hollyrock/AuraLinc-Community/docs/docs/repo-map.md

# リポジトリ案内

この公開コミュニティリポジトリで見られるファイルの場所です。

## オープンソースファイル

| フォルダ | 内容 |
| --- | --- |
| `firmware/main/` | EcoCONNECT制御用コード（microPython） |
| `firmware/pico2/` | 書き込み用ファームウェア(バイナリ＆ソース) |
| `hardware/main-board/` | メインボード設計ファイル（OSHWA） |
| `hardware/main-board/libs/` | KiCad シンボル・フットプリント |

## すすめ方

1. [技術情報](./getting-started) でEcoCONNECTを動かす
2. 設計を見たくなったら `hardware/main-board/` を KiCad で開く
