hollyrock/AuraLinc-Community/docs/en/community/index.md

# Community plaza

Share ideas, questions, and suggestions. This plaza is primarily in Japanese. English posts are welcome in the same thread.

You can also open [Discussions on GitHub](https://github.com/hollyrock/AuraLinc-Community/discussions).

<Giscus lang="en" />
