hollyrock/AuraLinc-Community/docs/en/docs/index.md

# Documentation

Technical documentation for EcoCONNECT: getting started, tutorials, where files live in the repository, and FAQ.

## Contents

| Page | What you’ll find |
| --- | --- |
| [What is EcoCONNECT?](./what-is-ecoconnect) | Project overview |
| [Repo map](./repo-map) | Public file locations |
| [Use with AuraLinc](./auralinc/tutorials/) | Manual for AuraLinc (commercial edition) |
| [Hack!](./hack/getting-started) | A step further into how to use the device |

Share ideas and questions in the [Community plaza](/en/community/).
Materials for education are in [Workshop materials](/en/steam/).
