hollyrock/AuraLinc-Community/docs/en/docs/repo-map.md

# Repo map

Where to find the open files in this public community repository.

## Open-source files

| Folder | Contents |
| --- | --- |
| `firmware/main/` | Control code for EcoCONNECT (MicroPython) |
| `firmware/pico2/` | Firmware to flash (binary and source) |
| `hardware/main-board/` | Main-board design files (OSHWA) |
| `hardware/main-board/libs/` | KiCad symbols and footprints |

## Suggested path

1. Get EcoCONNECT running with [Hack!](./hack/getting-started)
2. When you want to look at the design, open `hardware/main-board/` in KiCad
