hollyrock/AuraLinc-Community/docs/en/steam/classroom.md

# Workshop ideas

EcoCONNECT supports **Science, Technology, Engineering, Arts, and Mathematics** through short, tangible activities.

## Sample lesson hooks

| Subject | Prompt |
| --- | --- |
| Science | How does light in the room change during the day? |
| Technology | What does a sensor “tell” a computer? |
| Engineering | How would you protect a board used outdoors? |
| Arts | Turn sensor values into color, sound, or a paper data poster |
| Math | Graph 10 readings. What is the average? The range? |

## Facilitation tips

- Keep groups small (2–3 students)
- Aim for one clear question per session
- End with a share-out: each group says one discovery

## Share your lesson

Classroom adaptations are welcome in the [gallery](/en/community/) — photos of posters and student setups help the next teacher.
