hollyrock/AuraLinc-Community/docs/en/steam/examples.md

# Project examples

Need inspiration? Start with one of these small projects.

## Indoor light diary

Measure light in the same spot every hour for one day. Make a simple chart.

## Warm hands, cool air

Compare a reading near a window with a reading near the center of the room.

## Club demo booth

Prepare a 60-second demo: show a live reading and explain what the sensor detects.

## Remix ideas

- Add a paper enclosure (art + engineering)
- Translate labels into another language
- Design a better cable-management stand

When you finish a project, add it to the [gallery](/en/community/).
