hollyrock/AuraLinc-Community/docs/en/steam/recipes.md

# Recipes

Recipes are **tiny activities** you can finish in one short session.

## Recipe: Quiet baseline

1. Power on the board.
2. Don’t touch the sensor for one minute.
3. Write down the most common reading you see.
4. That number is your “quiet baseline.”

## Recipe: One change only

1. Note your baseline.
2. Change **one** thing (light, distance, airflow…).
3. Wait 20 seconds.
4. Note the new reading.
5. Talk about cause and effect.

## Recipe: Teach a friend

Explain EcoCONNECT to a partner in under two minutes using only everyday words — no jargon contest!
