hollyrock/AuraLinc-Community/docs/en/docs/hack/remote.md

# Send data wirelessly

How to send data collected by EcoCONNECT to a local PC.

## Data path from EcoCONNECT to the PC

## Configuration

1. Change the gateway settings.
2. Start the server service on the PC.
3. Check the data.
