hollyrock/AuraLinc-Community/docs/docs/hack/spec.md

# 移動しました

<script setup>
import { onMounted } from 'vue'
import { withBase } from 'vitepress'
onMounted(() => {
  window.location.replace(withBase('/docs/spec'))
})
</script>

このページは [仕様](/docs/spec) に移動しました。
