hollyrock/AuraLinc-Community/docs/index.md

---
layout: home

hero:
  name: AuraLinc
  text: コミュニティ
  tagline: ドキュメント・ワークショップ資料・みんなの広場。AuraLinc EcoCONNECT で広がるMakersの世界。
  actions:
    - theme: brand
      text: ドキュメント
      link: /docs/
    - theme: alt
      text: ワークショップ資料
      link: /steam/

features:
  - title: ドキュメント
    details: はじめ方、チュートリアル、技術情報はここに集約しています。
    link: /docs/
  - title: ワークショップ資料
    details: ワークショップや学校での利用に役立つテンプレート、ワークシート、短い活動例があります。
    link: /steam/
  - title: コミュニティ広場
    details: アイデア・質問・提案を共有。
    link: /community/
---
