hollyrock/AuraLinc-Community/docs/docs/index.md

# ドキュメント

EcoCONNECT の技術ドキュメントです。はじめ方・チュートリアル・リポジトリ内のファイル場所・FAQ をまとめています。

## 目次

| ページ | 内容 |
| --- | --- |
| [EcoCONNECT とは？](./what-is-ecoconnect) | プロジェクトの概要 |
| [リポジトリ案内](./repo-map) | 公開ファイルの場所 |
| [技術情報](./getting-started) | 一歩進んだ使い方をご紹介します |
| [AuraLincで使う](./auralinc/tutorials/) | AuraLinc（商用版）のマニュアル |

アイデアや質問の共有は [コミュニティ広場](/community/) へ。
教育向けの資料は [ワークショップ資料](/steam/) へ。
