hollyrock/AuraLinc-Community/docs/community/index.md

# コミュニティ広場

アイデア・質問・提案を分かち合う場所です。会話の基本は日本語です。英語でも同じスレッドに書けます。

[GitHub Discussions](https://github.com/hollyrock/AuraLinc-Community/discussions) で直接見ることもできます。

<Giscus lang="ja" />
