hollyrock/AuraLinc-Community/docs/docs/remote.md

# 無線でデータを送る

EcoCONNECTで取得したデータをローカルPCに送る方法を解説します。

## EcoCONNECTからPCまでのデータ経路

## コンフィギュレーション

1. ゲートウェイの設定を変更する。
2. PCでサーバーサービスを起動する。
3. データを確認する。
