hollyrock/AuraLinc-Community/docs/en/index.md

---
layout: home

hero:
  name: AuraLinc
  text: Community
  tagline: Docs, STEAM materials, and a shared plaza — AuraLinc EcoCONNECT by hollyRock for classrooms and clubs.
  actions:
    - theme: brand
      text: Docs
      link: /en/docs/
    - theme: alt
      text: Workshop
      link: /en/steam/

features:
  - title: Docs
    details: Getting started, tutorials, repo map, and FAQ — technical info in one place.
    link: /en/docs/
  - title: Workshop
    details: Classroom templates, worksheets, and short activities for educators.
    link: /en/steam/
  - title: Community
    details: Share ideas, questions, and suggestions via GitHub Discussions (giscus).
    link: /en/community/
---
