hollyrock/AuraLinc-Community/docs/steam/classroom.md

# ワークショップのアイデア

EcoCONNECT は、短い・手触りのある活動を通して **STEAM**（Science / Technology / Engineering / Arts / Mathematics）を支えます。

## ワークショップのとっかかり例

| 教科 | 問いかけ |
| --- | --- |
| Science | 教室の明るさは一日でどう変わる？ |
| Technology | センサーはコンピュータに何を「伝える」？ |
| Engineering | 屋外で使うとき、ボードをどう守る？ |
| Arts | センサーの値を色・音・紙のポスターにする |
| Math | 10 回測って平均と範囲を出す |

## 進め方のヒント

- グループは少人数（2〜3 人）
- 1 回の授業で問いをひとつに絞る
- 終わりに一言シェア：各グループが「発見」をひとつ発表

## ワークショップ案の共有

ワークショップでのでのアレンジは [ギャラリー](/community/) へどうぞ。ポスターやセットアップの写真が、次の助けになります。
