hollyrock/AuraLinc-Community/docs/steam/index.md

# ワークショップ資料

EcoCONNECT をワークショップ等で使うときの、テンプレート・ワークシートです。

## コンテンツ

| ページ | 内容 |
| --- | --- |
| [ワークショップ・アイデア](./classroom) | 内容別の問いかけと進め方 |
| [レシピ](./recipes) | 短時間で終わるアクティビティ |
| [事例](./examples) | 小さなプロジェクトのヒント |

技術的な手順やファイルの場所は [ドキュメント](/docs/) へ。
ワークショップの成果共有は [コミュニティ広場](/community/) へ。
