hollyrock/AuraLinc-Community/docs/steam/recipes.md

# レシピ

レシピは、短時間で終わる **小さなアクティビティ** です。
（順次公開予定です）
