hollyrock/AuraLinc-Community/docs/steam/examples.md

# プロジェクト事例

ヒントが欲しいときは、この小さなプロジェクトから。

## 室内の光日記

同じ場所の明るさを、1 時間ごとに 1 日測る。かんたんなグラフにする。

## あたたかい手、すずしい空気

窓際の計測と、部屋の中央の計測をくらべる。

## クラブのデモブース

60 秒デモを用意：ライブの数値を見せて、センサーが何を測っているか説明する。

## アレンジのアイデア

- 紙のケースを作る（Arts + Engineering）
- ラベルを別の言語にする
- ケーブル整理用のスタンドをデザインする

完成したら [ギャラリー](/community/) にどうぞ。
