hollyrock/AuraLinc-Community/docs/docs/hack/firmware.md

# 移動しました

<script setup>
import { onMounted } from 'vue'
import { withBase } from 'vitepress'
onMounted(() => {
  window.location.replace(withBase('/docs/firmware'))
})
</script>

このページは [ファームウェアと制御コードについて](/docs/firmware) に移動しました。
