hollyrock/AuraLinc-Community/docs/docs/hack/internal.md

# 移動しました

<script setup>
import { onMounted } from 'vue'
import { withBase } from 'vitepress'
onMounted(() => {
  window.location.replace(withBase('/docs/internal'))
})
</script>

このページは [EcoCONNECTの構造](/docs/internal) に移動しました。
