hollyrock/AuraLinc-Community/docs/docs/hack/recovery.md

# 移動しました

<script setup>
import { onMounted } from 'vue'
import { withBase } from 'vitepress'
onMounted(() => {
  window.location.replace(withBase('/docs/recovery'))
})
</script>

このページは [復旧](/docs/recovery) に移動しました。
