hollyrock/AuraLinc-Community/docs/docs/hack/remote.md

# 移動しました

<script setup>
import { onMounted } from 'vue'
import { withBase } from 'vitepress'
onMounted(() => {
  window.location.replace(withBase('/docs/remote'))
})
</script>

このページは [データを無線で送信する](/docs/remote) に移動しました。
