hollyrock/AuraLinc-Community/docs/docs/hack/ttn.md

# 移動しました

<script setup>
import { onMounted } from 'vue'
import { withBase } from 'vitepress'
onMounted(() => {
  window.location.replace(withBase('/docs/ttn'))
})
</script>

このページは [The Things Networkに繋げてみよう](/docs/ttn) に移動しました。
