hollyrock/AuraLinc-Community/docs/en/steam/index.md

# STEAM materials

Templates, worksheets, and short activities for educators using EcoCONNECT with STEAM in class.

## Contents

| Page | What you’ll find |
| --- | --- |
| [Classroom ideas](./classroom) | Subject prompts and facilitation tips |
| [Recipes](./recipes) | Quick session activities |
| [Examples](./examples) | Small project ideas |

Technical steps and file locations: [Docs](/en/docs/).  
Share outcomes and questions: [Community](/en/community/).
