hollyrock/AuraLinc-Community/docs/en/docs/hack/getting-started.md

# Let’s get started

Welcome!
This page introduces an overview of the technical information.

## Technical information

- [Structure](/en/docs/hack/internal)
- About the control code
- About the firmware
- About the LoRaWAN payload
- [Send data wirelessly](/en/docs/hack/remote)

## Other resources

- A [recipe](/en/steam/recipes) you can finish in about 10 minutes
- [Examples](/en/steam/examples) for ideas
- For teachers: [Workshop materials](/en/steam/)
