hollyrock/AuraLinc-Community/docs/docs/getting-started.md

# さぁ！始めよう！

ようこそ！
このページでは、ドキュメントの探索方法を紹介しています。

## EcoCONNECTの構造を理解する

- [EcoCONNECTの構造](/docs/internal)
- [ファームウェアと制御コードについて](/docs/firmware)

## EcoCONNECTのテクノロジを理解する

- [The Things Networkに繋げてみよう](/docs/ttn)
- [データを無線で送信する](/docs/remote)

## EcoCONNECTで何か作ってみる

- 10 分で終わる [レシピ](/steam/recipes)
- アイデア探しは [事例](/steam/examples)
- 先生向け：[ワークショップ資料](/steam/)
