hollyrock/AuraLinc-Community/docs/docs/hack/getting-started.md

# 移動しました

<script setup>
import { onMounted } from 'vue'
import { withBase } from 'vitepress'
onMounted(() => {
  window.location.replace(withBase('/docs/getting-started'))
})
</script>

このページは [ドキュメント](/docs/getting-started) に移動しました。
