hollyrock/AuraLinc-Community/docs/docs/tutorials/first-reading.md

# 移動しました

<script setup>
import { onMounted } from 'vue'
import { withBase } from 'vitepress'
onMounted(() => {
  window.location.replace(withBase('/docs/auralinc/tutorials/first-reading'))
})
</script>

はじめての計測は [はじめてのEcoCONNECT](/docs/auralinc/tutorials/first-reading) に移動しました。
