hollyrock/AuraLinc-Community/docs/docs/tutorials/index.md

# 移動しました

<script setup>
import { onMounted } from 'vue'
import { withBase } from 'vitepress'
onMounted(() => {
  window.location.replace(withBase('/docs/auralinc/tutorials/'))
})
</script>

チュートリアルは [AuraLincで使う](/docs/auralinc/tutorials/) に移動しました。
