hollyrock/AuraLinc-Community/docs/en/docs/getting-started.md

# Moved

<script setup>
import { onMounted } from 'vue'
import { withBase } from 'vitepress'
onMounted(() => {
  window.location.replace(withBase('/en/docs/hack/getting-started'))
})
</script>

Getting started moved to [Let’s get started](/en/docs/hack/getting-started).
