hollyrock/AuraLinc-Community/docs/docs/auralinc/tutorials/index.md

# チュートリアル

短いガイドつきのアクティビティです。上から順に進めると安心です。

## 初心者向けの道すじ

1. [はじめ方](/docs/getting-started) — 電源オンと書き込み
2. [はじめてのセンサー計測](/docs/auralinc/tutorials/first-reading) — 本物の数値を観察
3. [レシピ](/steam/recipes) をひとつ選ぶ — 小さな実験

## うまく進めるコツ

- 一度に一歩だけ読む
- うまくいかないときは、ひとつ前の手順に戻る
- 見たことをノートに書く — よい観察の第一歩です
