hollyrock/AuraLinc-Community/docs/en/docs/tutorials/first-reading.md

# Moved

<script setup>
import { onMounted } from 'vue'
import { withBase } from 'vitepress'
onMounted(() => {
  window.location.replace(withBase('/en/docs/auralinc/tutorials/first-reading'))
})
</script>

The first reading moved to [Your first EcoCONNECT](/en/docs/auralinc/tutorials/first-reading).
