hollyrock/AuraLinc-Community/docs/en/docs/tutorials/index.md

# Moved

<script setup>
import { onMounted } from 'vue'
import { withBase } from 'vitepress'
onMounted(() => {
  window.location.replace(withBase('/en/docs/auralinc/tutorials/'))
})
</script>

Tutorials moved to [Use with AuraLinc](/en/docs/auralinc/tutorials/).
