hollyrock/AuraLinc-Community/site/docs/tutorials/first-reading.html

Skip to content

 AuraLinc Community

日本語

English

(https://github.com/hollyrock/AuraLinc-Community)

日本語

English

外観

(https://github.com/hollyrock/AuraLinc-Community)

メニュー

ページ上部へ

# 移動しました

はじめての計測は はじめてのEcoCONNECT に移動しました。

好奇心あふれる社会づくりに貢献する

AuraLinc community / hollyRock
