hollyrock/AuraLinc-Community/site/en/docs/getting-started.html

Skip to content

 AuraLinc

English

日本語

(https://github.com/hollyrock/AuraLinc-Community)

English

日本語

Appearance

(https://github.com/hollyrock/AuraLinc-Community)

Menu

Return to top

# Moved

Getting started moved to Let’s get started.

Deliver the curiosity of STEAM to the world

AuraLinc community / hollyRock
