hollyrock/AuraLinc-Community/site/docs/auralinc/tutorials/index.html

Skip to content

 AuraLinc Community

日本語

English

(https://github.com/hollyrock/AuraLinc-Community)

日本語

English

外観

(https://github.com/hollyrock/AuraLinc-Community)

メニュー

ページ上部へ

# チュートリアル

短いガイドつきのアクティビティです。上から順に進めると安心です。

## 初心者向けの道すじ

1. はじめ方 — 電源オンと書き込み
2. はじめてのセンサー計測 — 本物の数値を観察
3. レシピ をひとつ選ぶ — 小さな実験

## うまく進めるコツ

- 一度に一歩だけ読む
- うまくいかないときは、ひとつ前の手順に戻る
- 見たことをノートに書く — よい観察の第一歩です

好奇心あふれる社会づくりに貢献する

AuraLinc community / hollyRock
