hollyrock/AuraLinc-Community/site/en/docs/tutorials/first-reading.html

Skip to content

 AuraLinc

English

日本語

(https://github.com/hollyrock/AuraLinc-Community)

English

日本語

Appearance

(https://github.com/hollyrock/AuraLinc-Community)

Menu

Return to top

# Moved

The first reading moved to Your first EcoCONNECT.

Deliver the curiosity of STEAM to the world

AuraLinc community / hollyRock
