hollyrock/AuraLinc-Community/site/en/docs/auralinc/tutorials/index.html

Skip to content

 AuraLinc

English

日本語

(https://github.com/hollyrock/AuraLinc-Community)

English

日本語

Appearance

(https://github.com/hollyrock/AuraLinc-Community)

Menu

Return to top

# Tutorials

Short guided activities. Start at the top and move down when you feel ready.

## Path for beginners

1. Getting started — power on and flash
2. Your first EcoCONNECT — watch a real measurement
3. Pick a recipe — try a small experiment

## Tips

- Read one step at a time
- If a step fails, go back one step
- Write down what you see — good observation starts with notes

Deliver the curiosity of STEAM to the world

AuraLinc community / hollyRock
