hollyrock/AuraLinc-Community/docs/docs/auralinc/faq.md

# FAQ

よくある質問です。ここにない内容は [コミュニティ広場](/community/) で聞いてください。

## ボード・書き込み

### 書き込み用のドライブが見つかりません

BOOTSEL を押しながら USB をさし直してください。Raspberry Pi Pico では、多くの場合 `RPI-RP2` という名前のドライブが表示されます。

### どのファイルをコピーすればよいですか？

`firmware/pico2/release/ecoconnect-pico2.uf2` を使います。手順は [はじめ方](../getting-started) と `firmware/pico2/README.md` を参照してください。

### 書き込み後に何も起きません

ケーブルを抜け差しし、電源ランプの有無を確認してください。それでもだめなら [コミュニティ広場](/community/) に状況（OS・ケーブル・表示されたドライブ名）を書いてください。

## ドキュメント・教室

### 授業用のワークシートはどこ？

[ワークショップ資料](/steam/) にテンプレートと短い活動例があります。

### 回路や設計ファイルはどこ？

[リポジトリ案内](../repo-map) を見てください。公開しているのはボード設計と書き込み用イメージです。

## コミュニティ

### 質問やアイデアはどこに投稿する？

[コミュニティ広場](/community/)（GitHub Discussions）を使います。
