hollyrock/AuraLinc-Community/hardware/main-board/ecoconnect-main-board.kicad_pcb

## KiCad design hardware/main-board/ecoconnect-main-board.kicad_pcb (2026-10-13)

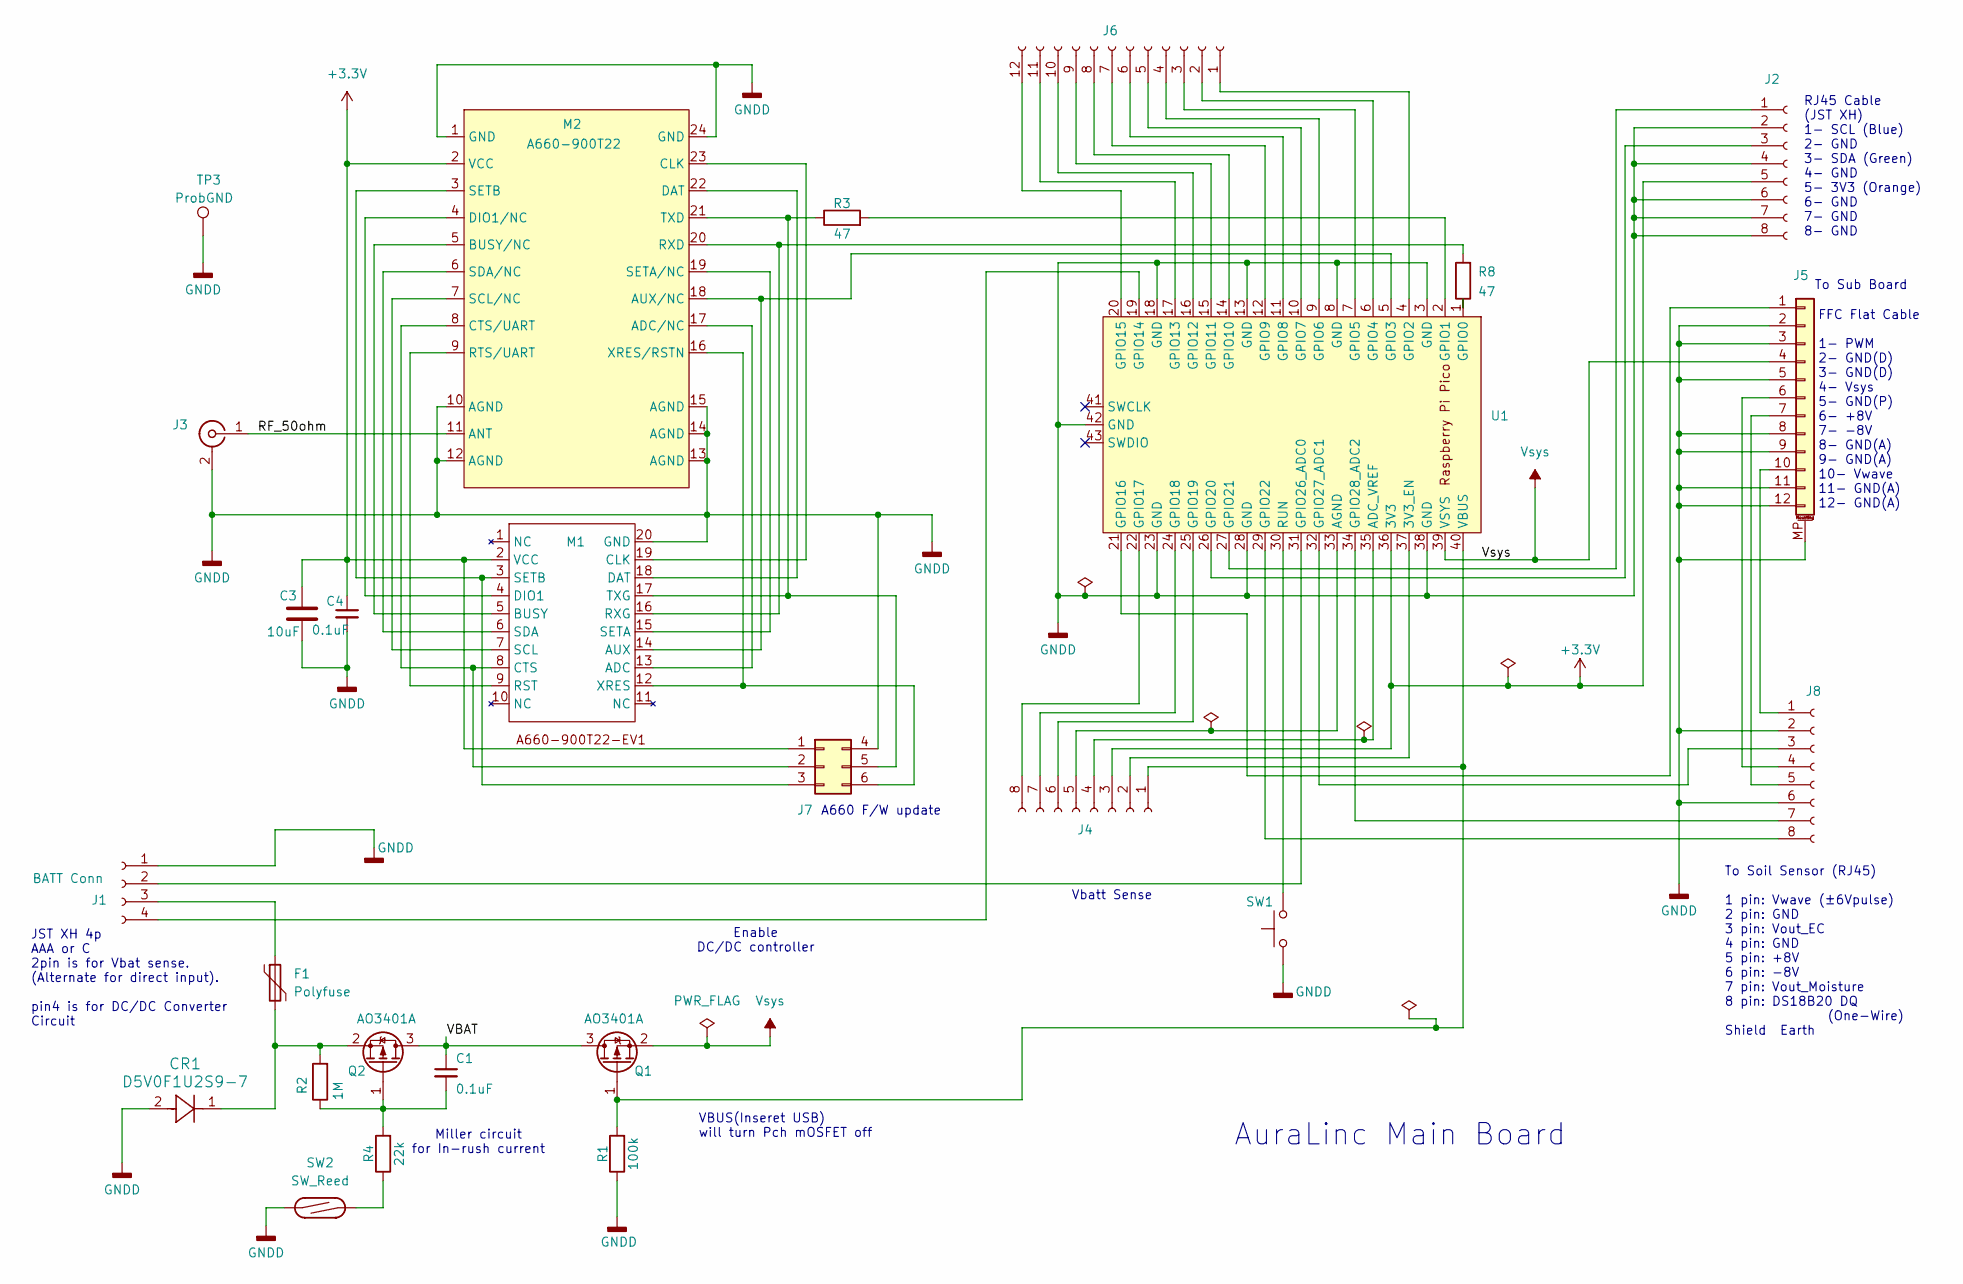
[picture p4: schematic ecoconnect-main-board.kicad_sch, AuraLinc Project]

Parts:
C1, C4: 0.1uF; C_0603_1608Metric_Pad1.08x0.95mm_HandSolder
C3: 10uF; C_0805_2012Metric_Pad1.18x1.45mm_HandSolder
CR1: D5V0F1U2S9-7; D5V0F1U2S9
F1: Polyfuse; FUS_MINISMDC075F_TYCO_TYC
J1: BATT Conn; JST_XH_B4B-XH-A_1x04_P2.50mm_Vertical
J2, J8: Conn_01x08_Socket; JST_XH_B8B-XH-AM_1x08_P2.50mm_Vertical
J3: Conn_Coaxial; SMA_Samtec_SMA-J-P-H-ST-EM1_EdgeMount
J4: Conn_01x08_Socket; PinHeader_1x08_P2.54mm_Vertical
J5: Conn_01x12_MountingPin; TE_1-84952-2_1x12-1MP_P1.0mm_Horizontal
J6: Conn_01x12_Socket; PinHeader_1x12_P2.54mm_Vertical
J7: Conn_02x03_Top_Bottom; PinSocket_2x03_P2.54mm_Vertical
M1: A660-900T22-EV1
M2: A660-900T22
Q1, Q2: AO3401A; SOT-23
R1: 100k; R_0805_2012Metric_Pad1.20x1.40mm_HandSolder
R2: 1M; R_0805_2012Metric_Pad1.20x1.40mm_HandSolder
R3, R8: 47; R_0805_2012Metric_Pad1.20x1.40mm_HandSolder
R4: 22k; R_0805_2012Metric_Pad1.20x1.40mm_HandSolder
SW1: SW_Omron_B3FS; SW_SPST_Omron_B3FS-100xP
SW2: SW_Reed; JST_XH_B2B-XH-AM_1x02_P2.50mm_Vertical
TP3: ProbGND; TestPoint_Keystone_5015_Micro_Mini
U1: RPi_Pico_SMD_TH

Connections:
+3.3V: C3.1, C4.1, J2.5, J4.3, J7.1, M1.2 (VCC), M2.2 (VCC), U1.36 (3V3)
/RF_50ohm: J3.1 (In), M2.11 (ANT)
/VBAT: C1.1, Q1.3 (D), Q2.3 (D)
GNDD: C3.2, C4.2, CR1.2, J1.1, J2.2, J2.4, J2.6, J2.7, J2.8, J3.2 (Ext), J5.2, J5.3, J5.5, J5.8, J5.9, J5.11, J5.12, J5.MP (MountPin), J7.4, J8.2, J8.6, M1.20 (GND), M2.1 (GND), M2.10 (AGND), M2.12 (AGND), M2.13 (AGND), M2.14 (AGND), M2.15 (AGND), M2.24 (GND), R1.1, SW1.1, SW2.1, TP3.1, U1.3 (GND), U1.8 (GND), U1.13 (GND), U1.18 (GND), U1.23 (GND), U1.28 (GND), U1.38 (GND), U1.42 (GND)
unnamed: J1.2, U1.31 (GPIO26_ADC0)
unnamed: F1.1, J1.3
unnamed: J1.4, U1.19 (GPIO14)
unnamed: J2.1, U1.27 (GPIO21)
unnamed: J2.3, U1.26 (GPIO20)
unnamed: J4.1, Q1.1 (G), R1.2, U1.40 (VBUS)
unnamed: J4.2, U1.37 (3V3_EN)
unnamed: J4.4, U1.35 (ADC_VREF)
unnamed: J4.5, U1.33 (AGND)
unnamed: J4.6, U1.25 (GPIO19)
unnamed: J4.7, U1.24 (GPIO18)
unnamed: J4.8, U1.22 (GPIO17)
unnamed: J5.1, U1.21 (GPIO16)
unnamed: J5.6, J8.4
unnamed: J5.7, J8.5
unnamed: J5.10, J8.1
unnamed: J6.1, U1.4 (GPIO2)
unnamed: J6.2, U1.6 (GPIO4)
unnamed: J6.3, U1.7 (GPIO5)
unnamed: J6.4, U1.9 (GPIO6)
unnamed: J6.5, U1.10 (GPIO7)
unnamed: J6.6, U1.11 (GPIO8)
unnamed: J6.7, U1.12 (GPIO9)
unnamed: J6.8, U1.14 (GPIO10)
unnamed: J6.9, U1.15 (GPIO11)
unnamed: J6.10, U1.16 (GPIO12)
unnamed: J6.11, U1.17 (GPIO13)
unnamed: J6.12, U1.20 (GPIO15)
unnamed: J7.2, M1.8 (CTS), M2.8 (CTS/UART)
unnamed: J7.3, M1.3 (SETB), M2.3 (SETB)
unnamed: J7.5, M1.17 (TXG), M2.21 (TXD), R3.1
unnamed: J7.6, M1.12 (XRES), M2.16 (XRES/RSTN)
unnamed: J8.3, U1.32 (GPIO27_ADC1)
unnamed: J8.7, U1.34 (GPIO28_ADC2)
unnamed: J8.8, U1.29 (GPIO22)
unnamed: M1.13 (ADC), M2.17 (ADC/NC)
unnamed: M1.14 (AUX), M2.18 (AUX/NC), U1.5 (GPIO3)
unnamed: M1.5 (BUSY), M2.5 (BUSY/NC)
unnamed: M1.19 (CLK), M2.23 (CLK)
unnamed: M1.18 (DAT), M2.22 (DAT)
unnamed: M1.4 (DIO1), M2.4 (DIO1/NC)
unnamed: M1.9 (RST), M2.9 (RTS/UART)
unnamed: M1.16 (RXG), M2.20 (RXD), R8.2
unnamed: M1.7 (SCL), M2.7 (SCL/NC)
unnamed: M1.6 (SDA), M2.6 (SDA/NC)
unnamed: M1.15 (SETA), M2.19 (SETA/NC)
unnamed: C1.2, Q2.1 (G), R2.1, R4.2
unnamed: CR1.1, F1.2, Q2.2 (S), R2.2
unnamed: R4.1, SW2.2
unnamed: R8.1, U1.1 (GPIO0)
unnamed: R3.2, U1.2 (GPIO1)
unnamed: SW1.2, U1.30 (RUN)
Vsys: J5.4, Q1.2 (S), U1.39 (VSYS)

Notes on the sheet:
To Soil Sensor (RJ45) 1 pin: Vwave (±6Vpulse) 2 pin: GND 3 pin: Vout_EC 4 pin: GND 5 pin: +8V 6 pin: -8V 7 pin: Vout_Moisture 8 pin: DS18B20 DQ (One-Wire) Shield Earth
FFC Flat Cable 1- PWM 2- GND(D) 3- GND(D) 4- Vsys 5- GND(P) 6- +8V 7- -8V 8- GND(A) 9- GND(A) 10- Vwave 11- GND(A) 12- GND(A)
To Sub Board
A660 F/W update
AuraLinc Main Board
Miller circuit for In-rush current
VBUS(Inseret USB) will turn Pch mOSFET off
Enable DC/DC controller
Vbatt Sense
RJ45 Cable (JST XH) 1- SCL (Blue) 2- GND 3- SDA (Green) 4- GND 5- 3V3 (Orange) 6- GND 7- GND 8- GND
JST XH 4p AAA or C 2pin is for Vbat sense. (Alternate for direct input). pin4 is for DC/DC Converter Circuit

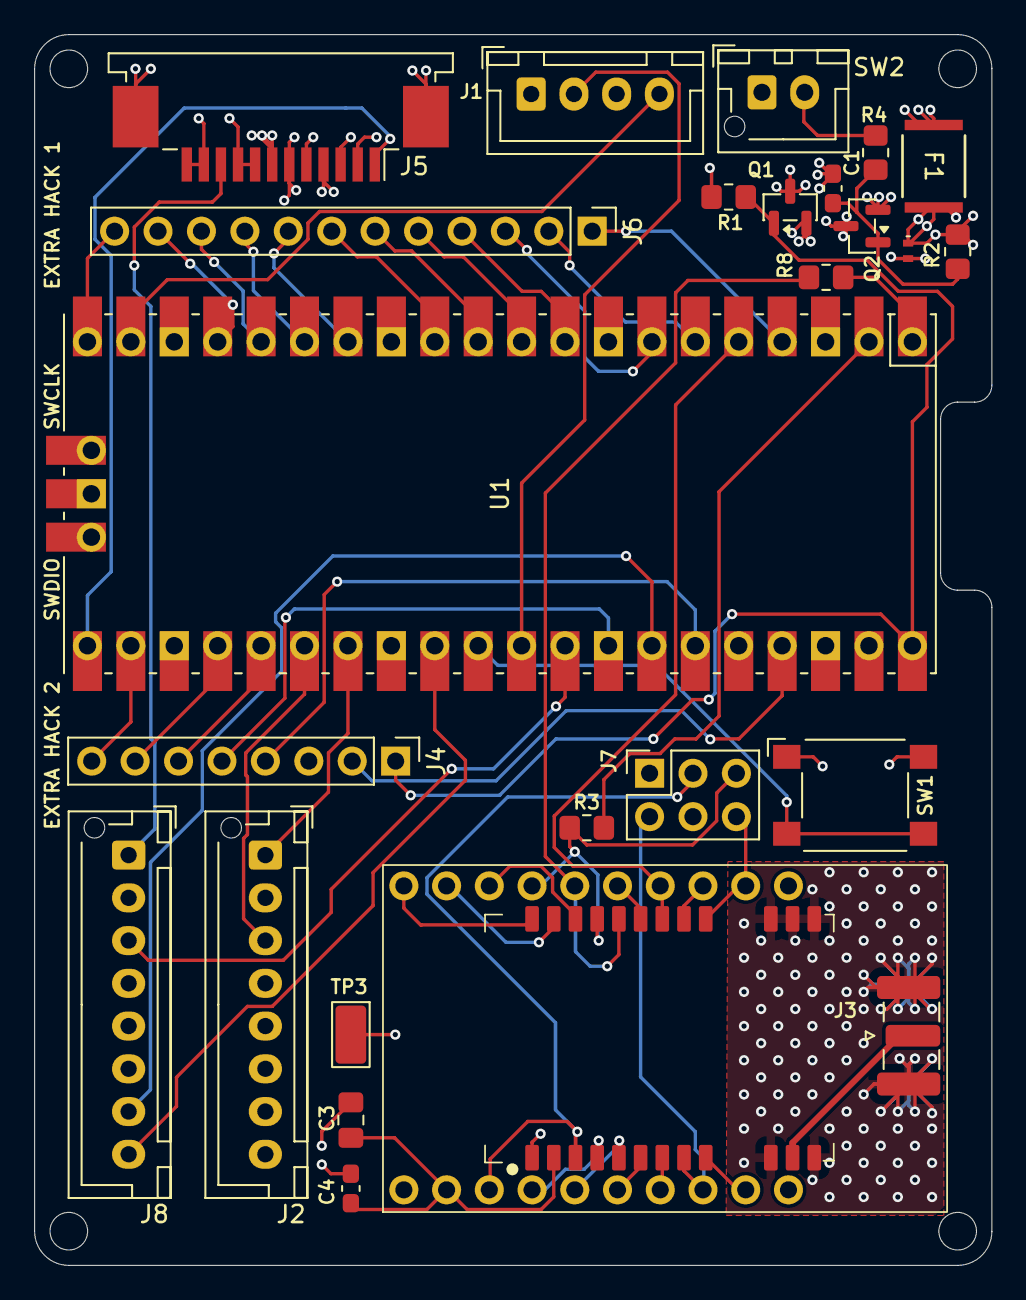
[picture p5: board ecoconnect-main-board.kicad_pcb from above]

Board: 4 copper layers, 56.0 x 72.0 mm, 26 parts (0 on the bottom side), 57 nets.
