hollyrock/AuraLinc-Community/hardware/steam-board/ecoconnect-steam-board.kicad_pcb

## KiCad design hardware/steam-board/ecoconnect-steam-board.kicad_pcb (2026-10-13)

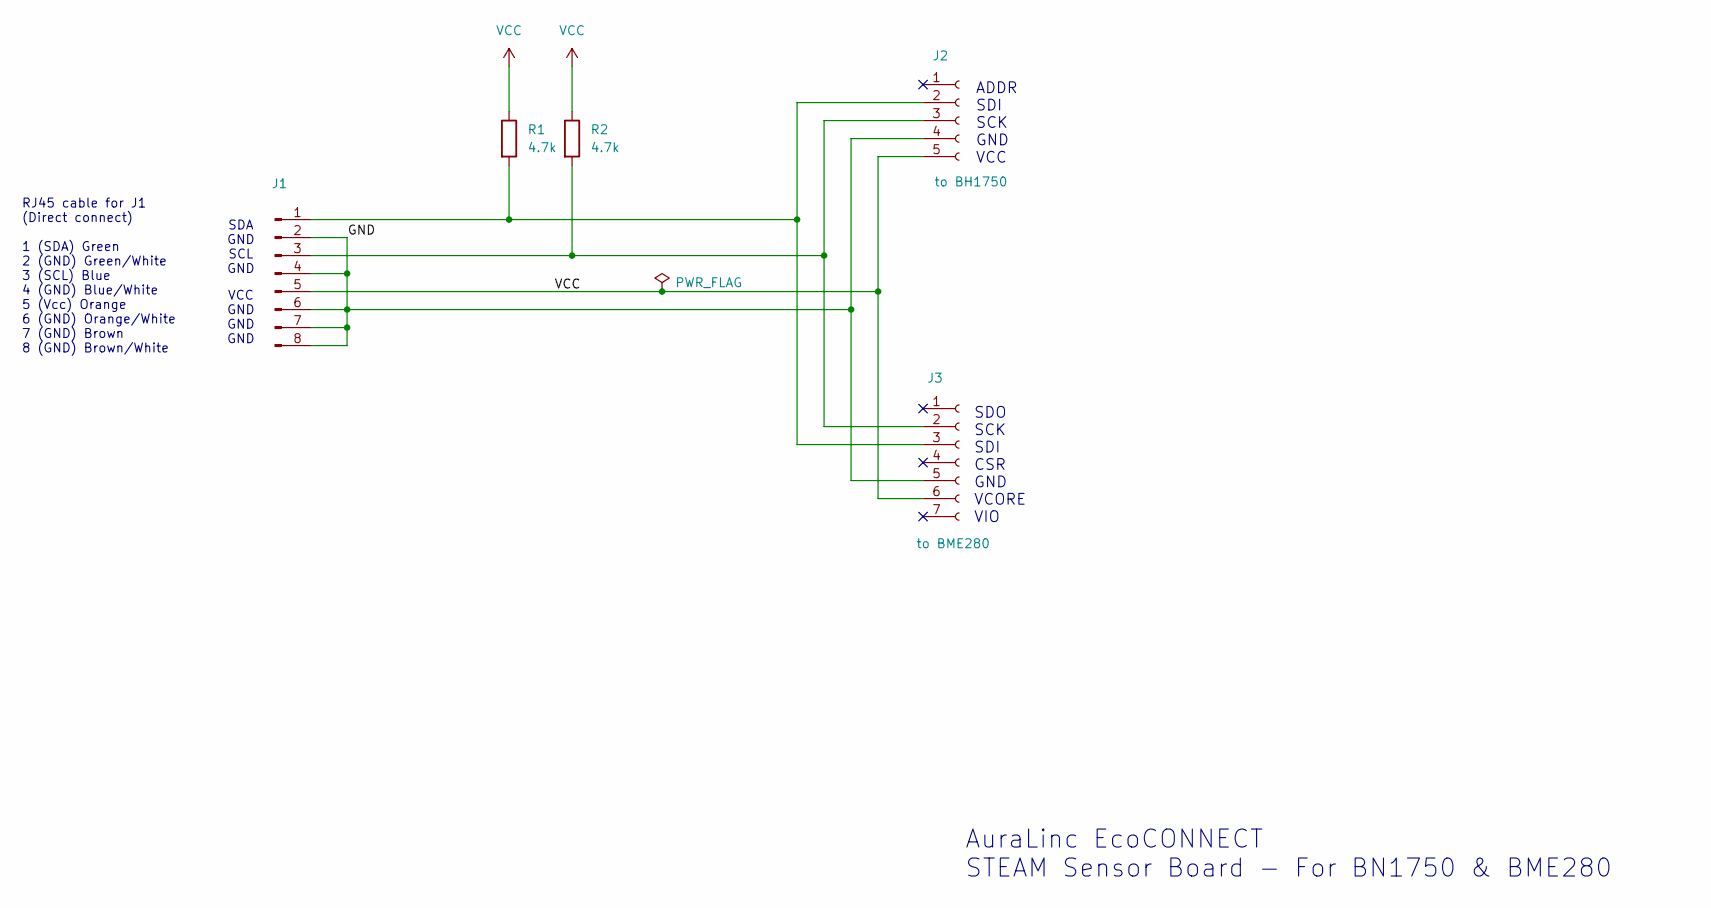
[picture p6: schematic ecoconnect-steam-board.kicad_sch, AuraLinc EcoCONNECT - sensor board]

Parts:
J1: Conn_01x08_Pin; 8 through hole -zigzag
J2: to BH1750; PinHeader_1x05_P2.54mm_Vertical
J3: to BME280; PinHeader_1x07_P2.54mm_Vertical
R1, R2: 4.7k; R_0805_2012Metric

Connections:
/GND: J1.2, J1.4, J1.6, J1.7, J1.8, J2.4, J3.5
unnamed: J1.1, J2.2, J3.3, R1.2
unnamed: J1.3, J2.3, J3.2, R2.2
VCC: J1.5, J2.5, J3.6, R1.1, R2.1

Notes on the sheet:
VCC GND GND GND
AuraLinc EcoCONNECT STEAM Sensor Board - For BN1750 & BME280
SDA GND SCL GND
ADDR SDI SCK GND VCC
RJ45 cable for J1 (Direct connect) 1 (SDA) Green 2 (GND) Green/White 3 (SCL) Blue 4 (GND) Blue/White 5 (Vcc) Orange 6 (GND) Orange/White 7 (GND) Brown 8 (GND) Brown/White
SDO SCK SDI CSR GND VCORE VIO

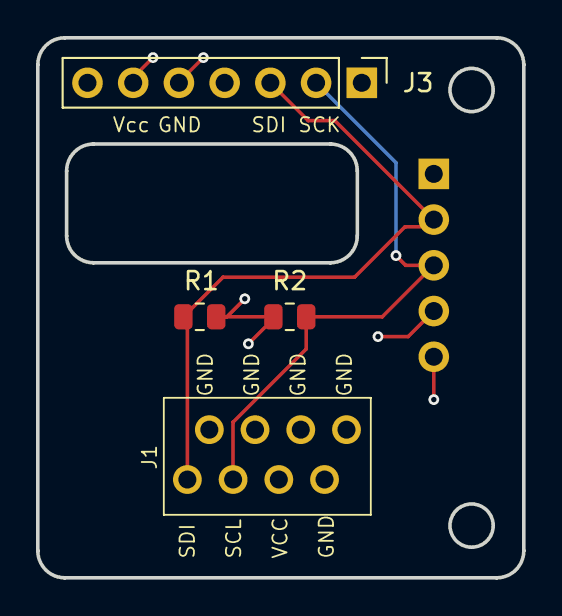
[picture p7: board ecoconnect-steam-board.kicad_pcb from above]

Board: 4 copper layers, 27.0 x 30.0 mm, 5 parts (1 on the bottom side), 4 nets.
