hollyrock/AuraLinc-Community/(commit log)

2026-09-20 Publish EcoCONNECT community site with beginner docs, firmware image, and open hardware.
    Keep internal source and management tooling local so the public repo stays clear for newcomers.
    [ecoconnect-main-board.kicad_pcb, ecoconnect-main-board.kicad_sch]
2026-09-21 Add Japanese-first docs with English locale switcher.
    Keep EcoCONNECT, hollyRock, Raspberry Pi Pico, and STEAM as English product names in JA copy.
    [ecoconnect-main-board.kicad_pcb, ecoconnect-main-board.kicad_sch]
2026-09-21 Simplify site into Docs, STEAM materials, and Community plaza.
    Add FAQ and giscus-ready Discussions embed; keep old paths as move stubs.
2026-10-13 Publish the EcoCONNECT STEAM board design copied by the local sync.
    [ecoconnect-steam-board.kicad_pcb, ecoconnect-steam-board.kicad_sch]
2026-10-13 Point documentation links at the current AuraLinc and hack pages.
    Keep the old getting-started and tutorial URLs as redirects so those pages still open.
2026-10-13 Publish the EcoCONNECT technical notes and the updated hack overview in English.
    Include the board images used by those pages.
    [ecoconnect-main-board.kicad_pcb, ecoconnect-steam-board.kicad_pcb]
2026-10-13 Update the main board and STEAM board photos on the technical notes.
